zm0612/desktop_assistant/doc/需要单独购买的配件.xlsx

名称 | 分类 | 购买链接 | 参考价格
1.54寸IPS液晶屏方形屏240×240接口SPI芯片ST7789P3通用接口12P | 焊接12PIN | https://item.taobao.com/item.htm?id=1030565906952&skuId=6208983230957 | 6.64
全新3.7V聚合物锂电池602535P/062535P600MAH捷渡d720行车记录仪 | 乳白色 | https://item.taobao.com/item.htm?id=619805501404&skuId=4627654124872 | 3.5
