zm0612/desktop_assistant/model/back_cover.stl

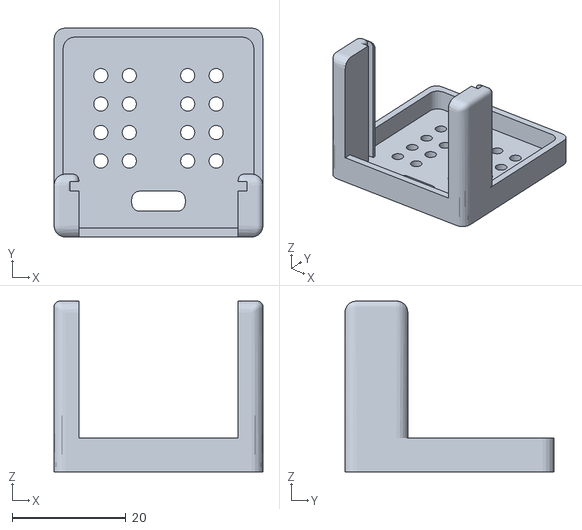
[picture p4: CAD file, 2026-11-01]
model/back_cover.stl
36.7 x 36.7 x 30.0
