zm0612/desktop_assistant/model/bracket_1.stl

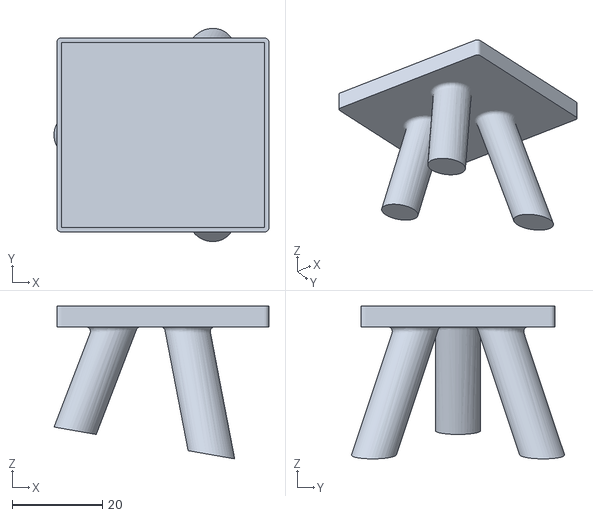
[picture p5: CAD file, 2026-11-01]
model/bracket_1.stl
47.6 x 47.2 x 33.8
