zm0612/desktop_assistant/model/bracket_0.stl

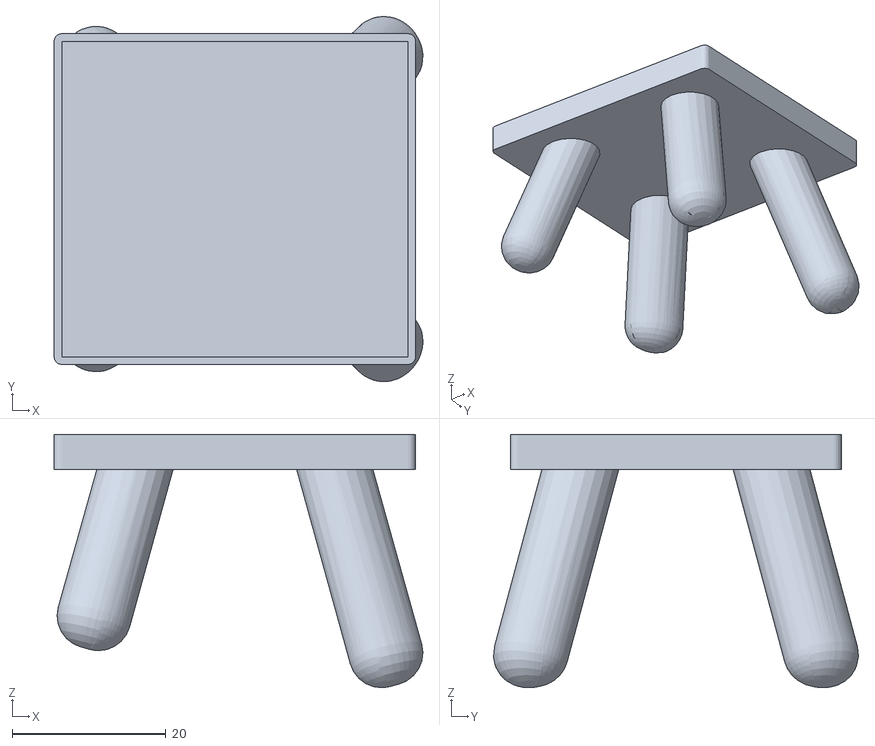
[picture p6: CAD file, 2026-11-01]
model/bracket_0.stl
47.9 x 47.4 x 32.9
