zm0612/desktop_assistant/model/housing.stl

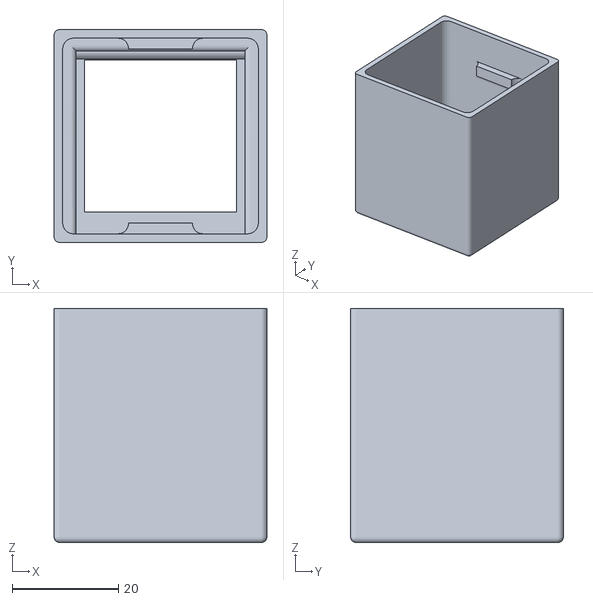
[picture p7: CAD file, 2026-11-01]
model/housing.stl
40.0 x 40.0 x 44.0
