zm0612/desktop_assistant/code/include/color_type.h

//
// Created by Zhang Zhimeng on 2026/8/28.
//
#pragma once

// ============================================
// ST7789 16位色 (RGB565) 常用颜色定义
// ============================================

// ----- 基础色 -----
#define COLOR_BLACK       0x0000
#define COLOR_WHITE       0xFFFF
#define COLOR_RED         0xF800
#define COLOR_GREEN       0x07E0
#define COLOR_BLUE        0x001F
#define COLOR_YELLOW      0xFFE0
#define COLOR_CYAN        0x07FF
#define COLOR_MAGENTA     0xF81F

// ----- 灰色系 -----
#define COLOR_GRAY        0x8410
#define COLOR_DARK_GRAY   0x4208
#define COLOR_LIGHT_GRAY  0xC618

// ----- 彩色系 -----
#define COLOR_ORANGE      0xFD20
#define COLOR_PINK        0xFDB8      // 亮粉红（肉眼可见的粉色）
#define COLOR_PURPLE      0x8010
#define COLOR_BROWN       0xA144
#define COLOR_GRASS_GREEN 0x77E0
#define COLOR_SKY_BLUE    0x051F
#define COLOR_INDIGO      0x4810
